gordominossi/DJController/(list of files, drawings)

Other design files:
HW/MIDI2_out.dsn
