gordominossi/DJController/HW/MIDI2_out.kicad_pcb

## KiCad design HW/MIDI2_out.kicad_pcb (2021-08-09)

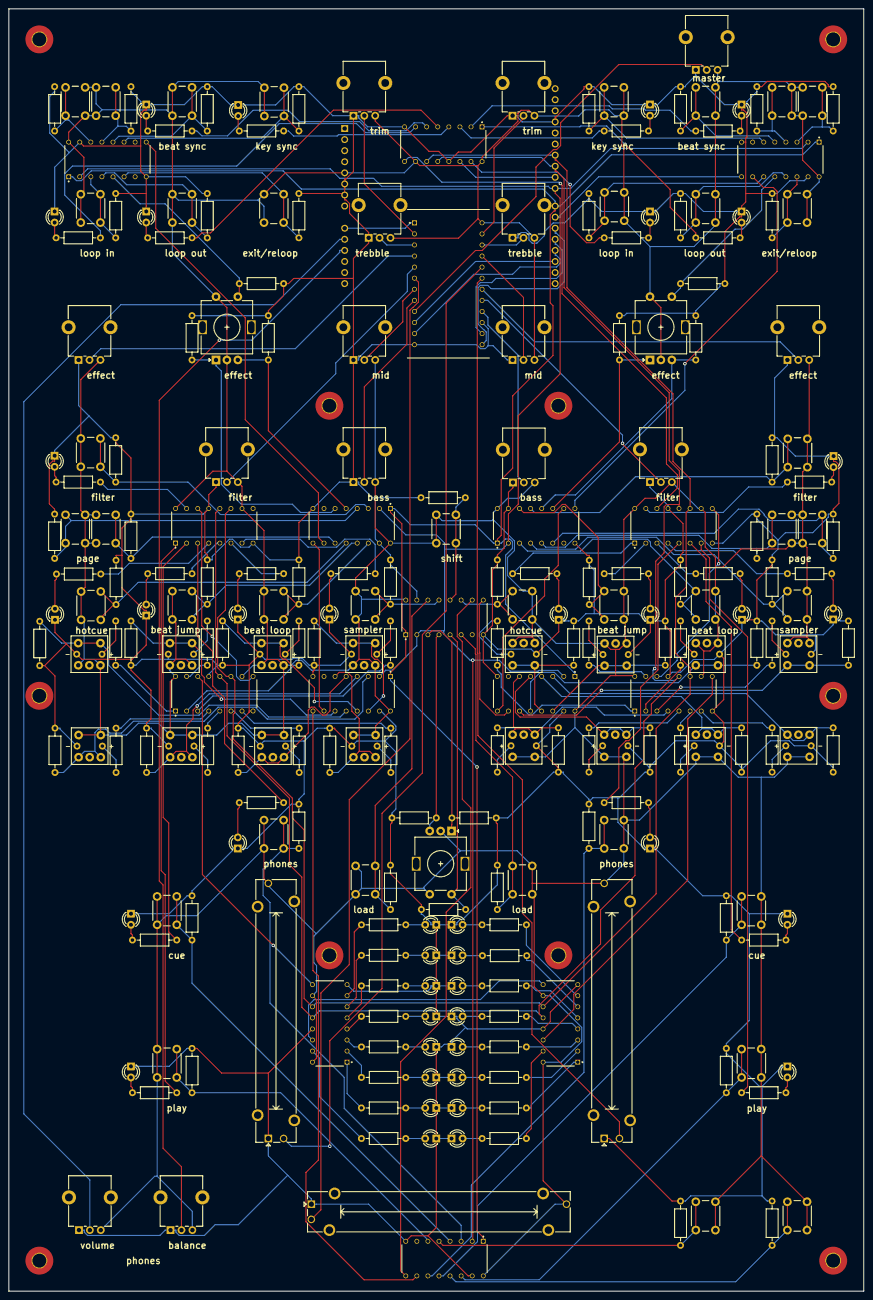
[picture p1: board MIDI2_out.kicad_pcb from above]

Board: 2 copper layers, 196.0 x 294.0 mm, 263 parts (1 on the bottom side), 220 nets.

Parts:
A1: Arduino_UNO_R3
B0, B1, B2, B3, B4, B5, B6, B7: 74HC165; DIP794W45P254L1969H508Q16
D1, D2, D3, D4, D5, D6, D7, D8, D9, D10, D11, D12, D13, D14, D15, D16, D25, D26, D27, D28, D29, D30, D31, D32, D41, D42, D43, D44, D45, D46, D47, D48, D49, D50, D51, D52, D53, D54, D55, D56: LED; LED_D3.0mm
H0, H1, H2, H3, H4, H5, H6, H7, H8, H9: MountingHole_3.2mm_M3_Pad_TopBottom
L0, L1, L2, L3, L4, L5, L6: 74AHC595; DIP794W45P254L1969H508Q16
M0: CD74HC4067M; DIP1549W45P254L3404H940Q24
R1, R2, R3, R4, R5, R6, R7, R8, R9, R10, R11, R12, R13, R14, R15, R16, R17, R18, R19, R20, R21, R22, R23, R24, R25, R26, R27, R28, R29, R30, R31, R32, R33, R34, R35, R36, R37, R38, R39, R40, R41, R42, R43, R44, R45, R46, R47, R48, R49, R50, R51, R52, R53, R54, R55, R56: 220; R_Axial_DIN0207_L6.3mm_D2.5mm_P10.16mm_Horizontal
R57, R58, R59, R60, R61, R62, R63, R64, R65, R66, R67, R68, R69, R70, R71, R72, R89, R90, R91, R93, R95, R96, R97, R98, R100, R102, R103, R105, R107, R108, R109, R110, R111, R113, R115, R116, R118, R119, R121, R122, R123, R124, R125, R126, R127, R128, R129, R131, R133, R134, R135, R136, R138, R140, R141, R142, R143, R144, R145, R146, R148, R149, R151, R152: 10k; R_Axial_DIN0207_L6.3mm_D2.5mm_P10.16mm_Horizontal
RV1, RV2, RV3, RV4, RV5, RV6, RV10, RV11, RV12, RV13, RV14, RV15, RV16, RV17, RV18: 10k; Potentiometer_Alpha_RD901F-40-00D_Single_Vertical_CircularH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
RV7, RV8, RV9: 10k; Potentiometer_Bourns_PTA4543_Single_Slide
SW1, SW2, SW4, SW5, SW7, SW9, SW11, SW12, SW14, SW15, SW19, SW21, SW22, SW23, SW24, SW26, SW27, SW29, SW30, SW31, SW33, SW34, SW36, SW37, SW38, SW40, SW41, SW43, SW44, SW45, SW46, SW47, SW49, SW50, SW52, SW53, SW54, SW56, SW57: SW_Push; SW_PUSH_6mm_H13mm
SW3, SW6, SW10, SW13, SW17, SW20, SW25, SW28, SW32, SW35, SW39, SW42, SW48, SW51, SW55, SW58: SW_SPST_LED_2; TS5
SW8, SW16, SW18: Rotary_Encoder_Switch; RotaryEncoder_Alps_EC11E-Switch_Vertical_H20mm

Connections:
+5V: A1.5, B0.16, B1.16, B2.16, B3.16, B4.16, B5.16, B6.16, B7.16, L0.10, L0.16, L1.10, L1.16, L2.10, L2.16, L3.10, L3.16, L4.10, L4.16, L5.10, L5.16, L6.10, L6.16, M0.24, RV1.3, RV2.3, RV3.3, RV4.3, RV5.3, RV6.3, RV7.3, RV8.3, RV9.3, RV10.3, RV11.3, RV12.3, RV13.3, RV14.3, RV15.3, RV16.3, RV17.3, RV18.3, SW1.2, SW2.2, SW3.1, SW3.2, SW4.2, SW5.1, SW6.1, SW6.2, SW7.2, SW8.C, SW8.S1, SW9.2, SW10.1, SW10.2, SW11.2, SW12.1, SW13.1, SW13.2, SW14.2, SW15.2, SW16.C, SW16.S2, SW17.3, SW17.4, SW18.C, SW18.S2, SW19.1, SW20.3, SW20.4, SW21.2, SW22.2, SW23.2, SW24.2, SW25.3, SW25.4, SW26.2, SW27.1, SW28.3, SW28.4, SW29.2, SW30.2, SW31.2, SW32.1, SW32.2, SW33.1, SW34.1, SW35.1, SW35.2, SW36.1, SW37.2, SW38.2, SW39.1, SW39.2, SW40.1, SW41.1, SW42.1, SW42.2, SW43.2, SW44.2, SW45.2, SW46.2, SW47.2, SW48.3, SW48.4, SW49.1, SW50.1, SW51.3, SW51.4, SW52.2, SW53.1, SW54.2, SW55.3, SW55.4, SW56.1, SW57.1, SW58.3, SW58.4
GND: A1.6, A1.7, A1.29, B0.8, B0.15, B1.8, B1.15, B2.8, B2.15, B3.8, B3.15, B4.8, B4.15, B5.8, B5.15, B6.8, B6.15, B7.8, B7.15, D1.1, D2.1, D3.1, D4.1, D5.1, D6.1, D7.1, D8.1, D9.1, D10.1, D11.1, D12.1, D13.1, D14.1, D15.1, D16.1, D25.1, D26.1, D27.1, D28.1, D29.1, D30.1, D31.1, D32.1, D41.1, D42.1, D43.1, D44.1, D45.1, D46.1, D47.1, D48.1, D49.1, D50.1, D51.1, D52.1, D53.1, D54.1, D55.1, D56.1, L0.8, L0.13, L1.8, L1.13, L2.8, L2.13, L3.8, L3.13, L4.8, L4.13, L5.8, L5.13, L6.8, L6.13, M0.12, M0.15, R57.2, R58.2, R59.2, R60.2, R61.2, R62.2, R63.2, R64.2, R65.2, R66.2, R67.2, R68.2, R69.2, R70.2, R71.2, R72.2, R89.2, R90.2, R91.2, R93.2, R95.2, R96.2, R97.2, R98.2, R100.2, R102.2, R103.2, R105.2, R107.2, R108.2, R109.2, R110.2, R111.2, R113.2, R115.2, R116.2, R118.2, R119.2, R121.2, R122.2, R123.2, R124.2, R125.2, R126.2, R127.2, R128.2, R129.2, R131.2, R133.2, R134.2, R135.2, R136.2, R138.2, R140.2, R141.2, R142.2, R143.2, R144.2, R145.2, R146.2, R148.2, R149.2, R151.2, R152.2, RV1.1, RV2.1, RV3.1, RV4.1, RV5.1, RV6.1, RV7.1, RV8.1, RV9.1, RV10.1, RV11.1, RV12.1, RV13.1, RV14.1, RV15.1, RV16.1, RV17.1, RV18.1, SW3.5, SW6.5, SW10.5, SW13.5, SW17.5, SW20.5, SW25.5, SW28.5, SW32.5, SW35.5, SW39.5, SW42.5, SW48.5, SW51.5, SW55.5, SW58.5
unnamed: A1.9, M0.1
unnamed: A1.10, RV17.2
unnamed: A1.11, RV18.2
unnamed: A1.17, M0.10
unnamed: A1.18, M0.11
unnamed: A1.19, M0.14
unnamed: A1.20, M0.13
unnamed: A1.21, B0.9
unnamed: A1.22, B0.1, B1.1, B2.1, B3.1, B4.1, B5.1, B6.1, B7.1
unnamed: A1.23, B0.2, B1.2, B2.2, B3.2, B4.2, B5.2, B6.2, B7.2
unnamed: A1.24, L0.14
unnamed: A1.25, L0.12, L1.12, L2.12, L3.12, L4.12, L5.12, L6.12
unnamed: A1.26, L0.11, L1.11, L2.11, L3.11, L4.11, L5.11, L6.11
unnamed: B0.3, R109.1, SW9.1
unnamed: B0.4, R96.1, SW1.1
unnamed: B0.5, R140.1, SW38.1
unnamed: B0.6, R122.1, SW21.1
unnamed: B0.10, B1.9
unnamed: B0.11, R144.1, SW36.2
unnamed: B0.12, R116.1, SW16.S1
unnamed: B0.13, R136.1, SW37.1
unnamed: B0.14, R126.1, SW26.1
unnamed: B1.3, R110.1, SW11.1
unnamed: B1.4, R97.1, SW2.1
unnamed: B1.5, R143.1, SW44.1
unnamed: B1.6, R123.1, SW22.1
unnamed: B1.10, B2.9
unnamed: B1.11, R90.1, SW16.A
unnamed: B1.12, R89.1, SW16.B
unnamed: B1.13, R133.1, SW43.1
unnamed: B1.14, R127.1, SW29.1
unnamed: B2.3, R63.1, SW28.1, SW28.2
unnamed: B2.4, R61.1, SW25.1, SW25.2
unnamed: B2.5, R59.1, SW20.1, SW20.2
unnamed: B2.6, R57.1, SW17.1, SW17.2
unnamed: B2.10, B3.9
unnamed: B2.11, R71.1, SW13.3, SW13.4
unnamed: B2.12, R69.1, SW10.3, SW10.4
unnamed: B2.13, R67.1, SW6.3, SW6.4
unnamed: B2.14, R65.1, SW3.3, SW3.4
unnamed: B3.3, R107.1, SW8.A
unnamed: B3.4, R103.1, SW8.B
unnamed: B3.5, R91.1, SW8.S2
unnamed: B3.6, R148.1, SW54.1
unnamed: B3.10, B4.9
unnamed: B3.11, R135.1, SW56.2
unnamed: B3.12, R134.1, SW49.2
unnamed: B3.13, R128.1, SW40.2
unnamed: B3.14, R118.1, SW33.2
unnamed: B4.3, R113.1, SW27.2
unnamed: B4.4, R105.1, SW19.2
unnamed: B4.5, R100.1, SW12.2
unnamed: B4.6, R93.1, SW5.2
unnamed: B4.10, B5.9
unnamed: B4.11, R149.1, SW57.2
unnamed: B4.12, R138.1, SW50.2
unnamed: B4.13, R131.1, SW41.2
unnamed: B4.14, R119.1, SW34.2
unnamed: B5.3, R64.1, SW48.1, SW48.2
unnamed: B5.4, R62.1, SW51.1, SW51.2
unnamed: B5.5, R60.1, SW55.1, SW55.2
unnamed: B5.6, R58.1, SW58.1, SW58.2
unnamed: B5.10, B6.9
unnamed: B5.11, R72.1, SW32.3, SW32.4
unnamed: B5.12, R70.1, SW35.3, SW35.4
unnamed: B5.13, R68.1, SW39.3, SW39.4
unnamed: B5.14, R66.1, SW42.3, SW42.4
unnamed: B6.3, R129.1, SW30.1
unnamed: B6.4, R141.1, SW46.1
unnamed: B6.5, R102.1, SW18.B
unnamed: B6.6, R115.1, SW18.A
unnamed: B6.10, B7.9
unnamed: B6.11, R124.1, SW23.1
unnamed: B6.12, R145.1, SW45.1
unnamed: B6.13, R95.1, SW4.1
unnamed: B6.14, R108.1, SW14.1
unnamed: B7.3, R125.1, SW31.1
unnamed: B7.4, R151.1, SW52.1
unnamed: B7.5, R146.1, SW18.S1
unnamed: B7.6, R142.1, SW53.2
unnamed: B7.11, R121.1, SW24.1
unnamed: B7.12, R152.1, SW47.1
unnamed: B7.13, R98.1, SW7.1
unnamed: B7.14, R111.1, SW15.1
unnamed: D1.2, R1.1
unnamed: D2.2, R2.1
unnamed: D3.2, R3.1
unnamed: D4.2, R4.1
unnamed: D5.2, R5.1
unnamed: D6.2, R6.1
unnamed: D7.2, R7.1
unnamed: D8.2, R8.1
unnamed: D9.2, R25.1
unnamed: D10.2, R26.1
unnamed: D11.2, R27.1
unnamed: D12.2, R28.1
unnamed: D13.2, R29.1
unnamed: D14.2, R30.1
unnamed: D15.2, R31.1
unnamed: D16.2, R32.1
unnamed: D25.2, R41.2
unnamed: D26.2, R42.2
unnamed: D27.2, R43.2
unnamed: D28.2, R44.2
unnamed: D29.2, R45.2
unnamed: D30.2, R46.2
unnamed: D31.2, R47.2
unnamed: D32.2, R48.2
unnamed: D41.2, R9.2
unnamed: D42.2, R10.2
unnamed: D43.2, R11.2
unnamed: D44.2, R12.2
unnamed: D45.2, R13.2
unnamed: D46.2, R14.2
unnamed: D47.2, R15.2
unnamed: D48.2, R16.2
unnamed: D49.2, R17.2
unnamed: D50.2, R18.2
unnamed: D51.2, R19.2
unnamed: D52.2, R20.2
unnamed: D53.2, R21.2
unnamed: D54.2, R22.2
unnamed: D55.2, R23.2
unnamed: D56.2, R24.2
unnamed: L0.1, R26.2
unnamed: L0.2, R27.2
unnamed: L0.3, R28.2
unnamed: L0.4, R29.2
unnamed: L0.5, R30.2
unnamed: L0.6, R31.2
unnamed: L0.7, R32.2
unnamed: L0.9, L1.14
unnamed: L0.15, R25.2
unnamed: L1.1, R42.1
unnamed: L1.2, R43.1
unnamed: L1.3, R44.1
unnamed: L1.4, R45.1
unnamed: L1.5, R46.1
unnamed: L1.6, R47.1
unnamed: L1.7, R48.1
unnamed: L1.9, L2.14
unnamed: L1.15, R41.1
unnamed: L2.1, R34.2
unnamed: L2.2, R35.2
unnamed: L2.3, R36.2
unnamed: L2.4, R37.2
unnamed: L2.5, R38.2
unnamed: L2.6, R39.2
unnamed: L2.7, R40.2
unnamed: L2.9, L3.14
unnamed: L2.15, R33.2
unnamed: L3.1, R2.2
unnamed: L3.2, R3.2
unnamed: L3.3, R4.2
unnamed: L3.4, R5.2
unnamed: L3.5, R6.2
unnamed: L3.6, R7.2
unnamed: L3.7, R8.2
unnamed: L3.9, L4.14
unnamed: L3.15, R1.2
unnamed: L4.1, R18.1
unnamed: L4.2, R19.1
unnamed: L4.3, R20.1
unnamed: L4.4, R21.1
unnamed: L4.5, R22.1
unnamed: L4.6, R23.1
unnamed: L4.7, R24.1
unnamed: L4.9, L5.14
unnamed: L4.15, R17.1
unnamed: L5.1, R50.2
unnamed: L5.2, R51.2
unnamed: L5.3, R52.2
unnamed: L5.4, R53.2
unnamed: L5.5, R54.2
unnamed: L5.6, R55.2
unnamed: L5.7, R56.2
unnamed: L5.9, L6.14
unnamed: L5.15, R49.2
unnamed: L6.1, R10.1
unnamed: L6.2, R11.1
unnamed: L6.3, R12.1
unnamed: L6.4, R13.1
unnamed: L6.5, R14.1
unnamed: L6.6, R15.1
unnamed: L6.7, R16.1
unnamed: L6.15, R9.1
unnamed: M0.2, RV16.2
unnamed: M0.3, RV14.2
unnamed: M0.4, RV12.2
unnamed: M0.5, RV10.2
unnamed: M0.6, RV8.2
unnamed: M0.7, RV6.2
unnamed: M0.8, RV4.2
unnamed: M0.9, RV2.2
unnamed: M0.16, RV1.2
unnamed: M0.17, RV3.2
unnamed: M0.18, RV5.2
unnamed: M0.19, RV7.2
unnamed: M0.20, RV9.2
unnamed: M0.21, RV11.2
unnamed: M0.22, RV13.2
unnamed: M0.23, RV15.2
unnamed: R33.1, SW3.6
unnamed: R34.1, SW6.6
unnamed: R35.1, SW10.6
unnamed: R36.1, SW13.6
unnamed: R37.1, SW17.6
unnamed: R38.1, SW20.6
unnamed: R39.1, SW25.6
unnamed: R40.1, SW28.6
unnamed: R49.1, SW32.6
unnamed: R50.1, SW35.6
unnamed: R51.1, SW39.6
unnamed: R52.1, SW42.6
unnamed: R53.1, SW48.6
unnamed: R54.1, SW51.6
unnamed: R55.1, SW55.6
unnamed: R56.1, SW58.6
